mseokq23/mychip/(commit log)

2026-10-31 Add an end-to-end smoke test; make etri-lvs compare pins
    scripts/smoke-test.sh draws a 3/0.6 um NMOS in Magic and checks every
    step: tools, kit files, the ngspice and Xschem examples, Magic DRC, GDS
    layer numbers, KLayout DRC, LVS (devices, W/L, pins) and the noVNC port.
    etri-lvs now keeps the top cell as a subcircuit when it has ports, so
    Netgen compares pin names too; without ports it falls back to the bare
    top level and says so. It prints one verdict line and flags property
    (W/L) errors instead of reporting them as a plain match.
2026-10-31 Generate MOS test transistors from code; add etri-check
    designs/etri050/gen/etri050_mos.py computes single-finger NMOS/PMOS
    geometry on Magic's lambda grid and has Magic draw it in batch mode, so
    contacts, implants and wells come from the kit's ETRI GDS style. Each
    cell gets a schematic netlist for LVS; the v0 table
    (designs/etri050/teg/devices_v0.csv) also builds an unrouted array.
    etri-check runs Magic DRC, ETRI GDS export, KLayout DRC and LVS on a
    cell and prints one summary line. The KLayout deck lacks end-cap,
    contact-to-gate and implant-enclosure rules, so both DRCs are needed.
    The smoke test now also parses ngspice-47 output, which drops the
    spaces around "=" in echo.
2026-10-31 klayout-etri: show all hierarchy levels of opened layouts
    KLayout draws only the top cell by default, so the transistor array
    opened as empty cell frames. A small startup macro turns on
    full-hierarchy-new-cell before the layouts load.
2026-10-31 Add integrated TEG chip v0 in the 28-pin pad frame
    designs/etri050/gen/etri050_teg_chip.py builds three blocks with Magic
    (NMOS matrix of 8 with shared gate/source/substrate, PMOS matrix of 6
    with shared gate/source/N-well, 90 x 90 um MOS capacitor), routes them
    on metal3 to the kit's bare 28-pin frame without crossings, and merges
    the core GDS with the unchanged frame GDS into teg_chip_v0.gds.
    Checks: Magic DRC of the blocks and the core, KLayout DRC of the core
    and of the whole chip, LVS of the flattened core with the pad nets as
    ports, and a pad check. A pad map lists each route's length in squares
    for series-resistance de-embedding. 21 pads are used, 7 are left free.
    Device lists live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
2026-10-31 TEG chip: fix exit vias for the kit's KLayout rules
    Magic's ETRI style trims 0.05 um off via metal edges that touch no
    other metal, which left sub-minimum metal1/metal2 teeth where a bus or
    strip was taller than its via: bus vias now sit inside the bus metal,
    and the source via1, strip and via2 share one height.
    The kit deck checks VIA2 enclosure only against metal3 narrower than
    10 um, so wide routes laid over an exit via cut its enclosure. Routes
    now meet each exit via2 through a narrow neck and widen beyond it.
2026-11-01 Add control block teg_ctrl with self-checking testbench and qflow script
    RTL: 20-bit scan chain with shadow register, block decoders (array rows 12,
    columns 8, CBCM 10, RO 6), RO select and divide-by-256 reset by osel.
    The same testbench runs on the RTL and on the netlist synthesized with the
    kit liberty (157 checks). run_flow.sh follows the kit RTL_Project/ETRI050
    qflow steps and the kit DRC/LVS/stacked-via checks; not run yet.
2026-11-01 Add ngspice block checks for the on-chip characterization IC
    Array path with PANA diodes from the GPIO GDS, Kelvin sense position,
    switch TG on-resistance, CBCM (accuracy, frequency, pad resistor, C-V),
    31-stage RO bank, scan chain and divider, PNP thermometer through the pad
    resistor, and the W 9 um L-split (saturation current, Terada-Muta).
    run_all.py compares each result with the value used in the chip plan.
    PDK models are unpacked from the kit docs archive into build/ only.
2026-11-01 Fix the qrouter Tcl/Tk lookup and run graywolf's tests without rsync
    qrouter's configure picked /usr/lib/tk8.6/tkConfig.sh from the unpacked
    tk8.6-dev, which on Debian only sources /usr/lib/<arch>/tk8.6/tkConfig.sh
    by absolute path; that file exists only in the sysroot, so configure
    stopped. The multiarch tclConfig.sh and tkConfig.sh are now named directly.
    graywolf's test scripts copy each case with rsync, which the image lacks,
    so 5 of 6 cases failed within 0.2 s before running the placer. The tests
    now run as a separate step with a stand-in that makes the same copy
    (cp -RL), and the summary reads that log.
2026-11-01 Point qflow's generated exec script at the unpacked tcsh; keep $TOOLS intact
    qflow writes qflow_exec.sh starting with "#!/bin/tcsh -f" and then execs
    it, so the first flow run stopped with "qflow_exec.sh: Command not found".
    The installer now rewrites every "!/bin/tcsh" in the installed qflow
    scripts (shebangs and the echo lines that write generated shebangs) as a
    separate step that is safe to repeat.
    run_flow.sh assigned its tool prefix to TOOLS, which the image exports as
    /foss/tools and which /foss/tools/bin/yosys uses to find the real binary,
    so yosys failed inside the flow. The variable is renamed.
2026-11-01 Shape the control block for its floorplan slot and keep top pins on the side
    The first full run placed 52 pins on a ~423 x 396 um core's top side and
    pushed the last one (col_selb[7]) to x = 441 um, past the 432 um edge, so
    qrouter found no taps for it (1 failed net, 1 LVS pin error).
    run_flow.sh now sets the GrayWolf core aspect ratio (height / width) to
    0.37 instead of the kit template's 1.0: 7 rows, core 663 x 252 um, which
    matches the wide, low slot under the array and the RO bank. The top pin
    groups get sidespace hints (array selects 0.0-0.6, RO bank 0.62-0.98) so
    they spread from the left instead of piling up at the right end.
2026-11-01 Simulate the qflow netlist after dropping its repeated port wire declarations
    qflow's vlog2Verilog writes ANSI ports and then declares some of them again as wires; Icarus Verilog (12 and 14) rejects that. strip_port_wires.py removes only those lines before make qflowsim compiles the netlist.
2026-11-01 Use 8 rows for the control block and add flat and official-rule DRC checks
    Measured with the kit flow: aspect ratio 0.49 gives 8 rows (core 582 x 288
    um, block 604 x 301 um), which fits the floorplan slot between PNP2 and
    CBCM; 0.37 gave 685 x 265 um, too wide for it.
    run_flow.sh now also flattens the block with the kit's mag2gds.sh, runs
    Magic DRC on the flat cell, and runs the kit's KLayout conversion of the
    official rule deck on the ETRI GDS, summarized in flow_summary.txt.
2026-11-01 Record the control block place-and-route results and the metal spacing finding
    Kit flow checks are clean (no failed routes, LVS match, DRC 0 with only subcell-overlap tiles, no stacked vias, qflow netlist PASS 157). The official-rule KLayout deck flags 0.9 um metal2/metal3 spacing, which the kit LEF and 20 of 34 kit cells use and which also appears in the kit's FIR_PE Calibre results; to be confirmed with ETRI.
2026-11-01 Generate the pdkv pad ring from the kit's 28-pin GPIO template and check it against the template
2026-11-01 Generate the L-split NMOS pair and the N-well MOS capacitor as Magic cells with LVS netlists
2026-11-01 Record the direct device checks and the plan for the PNP and heater cells
2026-11-01 Add the PDK pnp10 copy and a poly2 heater built with the p2res layer set, with an official-deck check
2026-11-01 Record the PDK pnp10 and heater cells and their official-deck results
2026-11-01 Freeze the placed and routed control block as a GDS macro for chip assembly
2026-11-01 Record the control block pin locations next to its GDS macro
2026-11-01 Snap the control block macro to the 0.01 um design grid
    The kit qflow route is drawn in Magic quarter-lambda units (0.075 um), so the
    filled block had 3068 metal2 and 64 contact coordinates off the 0.01 um design
    grid of the rule document; ETRI's Calibre deck checks OFFGRID per layer.
    snap_grid.py moves every such coordinate (an odd multiple of 0.005 um) up by
    0.005 um, keeps polygon counts and via/contact coverage, and run_flow.sh now
    checks the snapped copy with the official-rule deck. freeze_macro.sh writes the
    macro and its pin list; gds_xor.py compares layouts by geometry.
2026-11-01 Assemble pdkv_Top from the pad ring, control block and direct devices
    assemble.py places the blocks in die coordinates and draws the routes to the
    rule document (0.8 um vias 0.8 um apart, 9 um power/force lines, 0.01 um grid).
    chip_check.py extracts the metal connectivity and checks every intended net,
    shorts between nets or inside a block, floating metal and the grid; run_chip.sh
    builds missing inputs, assembles, and runs the official-rule deck and the check.
2026-11-01 Add layout images of the assembled chip
2026-11-01 Place PNP1 beside the L-split with the heater under both
    The plan's thermal group puts PNP1 next to the reference device so it can see
    the L-split's own heating and the heater power alike. PNP1 now sits 37 um from
    the L-split channel, and the heater's long edge is 32 um from both; the heater
    return runs above the RO area into PVSS, and the PNP1/L-split ground comes on
    its own branch from PVSS.
2026-11-01 Document the chip assembly, its checks and results
    Chip README: floorplan, thermal group, routing rules, power and signal routes,
    the three checks and the Codespace results (official deck: the 14 pad ring
    5.NSD.S1 markers only; rule-document metal rules: nothing new; connectivity
    PASS; grid 0). Control block README: the 0.01 um grid snap and the frozen
    macro. Top README: the direct devices and chip folders.
2026-11-01 Add the chip boundary and the rule document seal ring to pdkv_Top
    CHIPBOUNDARY (layer 0) is the 1.9 x 1.9 mm MPW standard chip around the pad ring. The seal ring is a
    block of its own, drawn in the outer 30 um as the rule document 4.21 figure gives it, read with the
    digitized-area tone of each layer (table 2.1). metal_rules.py skips the ring zone for rules 7-12 as the
    kit deck does and checks the ring against the figure; chip_check sees the ring as one metal net.
    PDKV_SEAL=0 leaves both out.
2026-11-01 Add the Kelvin device array and route it into pdkv_Top
    etri050_array.py generates the 12 x 8 array (NMOS rows 0-7, PMOS rows 8-11, seven
    geometries and the open reference column) with per-cell drain sense TGs, row gate
    drivers and column force/sense/park switches; Magic DRC and Netgen LVS are clean.
    The row parking devices are W 6 um instead of the plan's 3 um for antenna margin.
    assemble.py places it above the control block: a constrained left-edge channel takes
    the 40 select lines to the column ports and to a metal2 bus for the row drivers, and the
    west pads ANW, ADF, ADS, ASF, ASS and AG are routed in.
    chip_check.py now holds every chip net to exactly the block nets under its probe
    poin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
2026-11-01 Extract the array's Kelvin path resistances and simulate them
    designs/etri050/array/kelvin_r.py extracts, from the drawn GDS with KLayout's R
    extractor, the resistance left inside each cell's Kelvin loop: the source vias, strip
    and plate up to the ASS sense point, and the drain strip between the force via and the
    sense tap (rule document 5.2/5.3 typ and max), with the contacts apart. It writes a
    per-cell table for correcting measurements.
    sim/blocks/array_post.py puts these into array_path.py's harness with the drawn switch
    sizes and per-cell drain sense, and run_all.py checks the result (step 'post').
2026-11-01 Document the Kelvin array, its routing, checks and post-layout results
    designs/etri050/array/README.md describes the circuit and where it departs from the
    plan (row parking W 6 um, column parking TG, force TG 100.8/252 um), the layout, the
    check results, the Kelvin path table and the post-layout simulation. The chip README
    gets the array placement, routing, the stricter short check, the antenna check and the
    Codespace results; render_gds.py can hide layers (the array close-up hides the plate).
2026-11-01 Note the current density in the array's drain contact strips
2026-11-01 Give the L-split's contact strip width in the array current note
2026-11-01 Add the CBCM capacitance table and the post-layout simulation
    cbcm_c.py extracts every cell's two nodes from cbcm_full.gds and sums their
    couplings with the rule document's capacitance table (5.4, 5.5); cbcm_post.py
    runs the block netlist with that wiring capacitance and the structures' drawn
    geometry. The table showed that the NG rail stopped at the east pairs' via, so
    cells 0 and 1 lacked the 0.18 fF that NG adds to every other ND; the rail now
    runs past their ND column and all pairs are alike again.
2026-11-01 Place the CBCM block in the chip
    The block sits east of the control block at die (1144.0, 456.0). Its clock and
    enables come straight from the control block's east-edge pins (en3 and en4
    cross the control block's own en2 route in metal2), VCD and VCR go to E1 and
    E2 PADR, VDD comes from S7, and its gnd rails join the south and east VSS
    lines. run_chip.sh builds the block when it is missing.
2026-11-01 Add the RO bank generator and its simulation
    etri050_ro.py draws the INV, NAND, NOR and wire ring oscillators (31 stages,
    NAND2X1 enable stage, tap INVX1 -> INVX4) from kit cells in six rows, with the
    wire RO's metal1 serpentines above them, and checks the block with a
    flattened Magic DRC and LVS. FO4 and the poly2-resistor RO do not fit in the
    place left for the bank; the README gives the reasons. ro_post.py runs the
    drawn ROs with the plan's loads and with the drawn wiring capacitance.
2026-11-01 Place the RO bank in the chip
    The bank sits over the control block, right of the array's row bus, at die
    (856.0, 826.0). Its enables and taps run on metal3 tracks in the corridor
    over the control block to the top-edge ro_en / ro_in pins; ro_in3 and ro_in5
    (ROs not built) stay tied to VSS. VDD comes from the control block's vdd bar
    on a metal1 line under the array channel, VSS from its gnd bar.
2026-11-01 Use each_circuit_top_down in the chip and antenna checks
    Netlist.top_circuit() is missing in KLayout 0.28 (the Ubuntu package);
    each_circuit_top_down() exists in 0.28 and 0.30 and gives the same circuit
    for the flat chip extraction. cbcm_c.py already uses it.
2026-11-01 Record the chip and simulation results with the RO bank
    Chip README: the RO bank in the block table, floorplan, power, signals,
    checks and results (local KLayout 0.28.16 run, checked against the
    Codespace record by re-running the merged state). The free areas left on
    the chip, measured from the chip GDS, include a strip above the heater's
    return line that takes the resistor RO, so that RO is planned as a block
    of its own instead of dropped; only FO4 stays out.
2026-11-01 Add the resistor RO block
    The plan's poly2-resistor RO (control-block index 5) did not fit the RO
    bank's place, but the chip has a free strip above the heater's return line
    (measured from the chip GDS), so it is a block of its own, rores: one
    flipped row in the interleaved order and, over every INVX1 stage, an upright
    poly2 resistor W 2 x L 80 um (40 squares) with the PDK p2res layer set;
    the stage output rises to its bottom head, a metal2 return line brings the
    top head down to the next stage's input.
    Magic draws each resistor's heads as a black-box cell p2r40 (LEFview), so
    Netgen compares the resistors as two-pin subcircuits and checks the ring
    order; KLayout inserts POLY2, CONT, LVSD, RE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
2026-11-01 Simulate the resistor RO before and after layout
    ro_post.py runs the resistor RO with the plan's loads plus the tap (68.6
    MHz, plan 69.1) and with the drawn wiring (rores_full.gds without POLY2)
    and the drawn resistor: p2res RSH x 40 squares with the PDK TC, a 50 ohm
    contact at each end and the body capacitance in ten segments (34.2 MHz).
    The rule document has no POLY2-to-field value, so POLY1's stands in as an
    upper bound; the run without body capacitance and RSH 110 / 140 ohm/sq
    bracket it. run_all.py checks both frequencies.
2026-11-01 Place the resistor RO in the chip
    The block sits at die (932.0, 1166.0) above the heater's return line.
    en5 / in5 cross the return line in metal3, run down the gap between the
    RO bank and MOS-C and join the corridor over the control block on two more
    tracks to ro_en[5] / ro_in[5]; ro_in5 is no longer tied to VSS. VDD and
    VSS come from the RO bank's west straps, apart from the heater's own
    return. run_chip.sh: 12 blocks, official deck 46 (unchanged), rules 7-12
    16 (all in the pad-ring baseline), 85 nets / 237 points PASS, no antenna
    violation without diffusion; a fresh checkout reproduces the same GDS.
2026-11-01 Check the resistor RO at device level
    Netgen compares each poly2 resistor as the black box p2r40 and never sees
    the POLY2, CONT, LVSD and RES shapes added after Magic. rores_lvs.py
    extracts rores_full.gds with KLayout (MOS4 transistors, resistor body =
    POLY2 & LVSD & RES at 125 ohm/sq, heads through CONT to MET1) and compares
    it with the generator's circuit at transistor level with 5000 ohm
    resistors: 35 NFET, 35 PFET, 30 RES match. Seven injected errors in the
    reference or the layout all give a mismatch. etri050_ro.py --check runs it.
    Docs: the stage load after the resistor is the plan's in shape but
    heavier (19.6-22.4 fF against 5 fF), so the chip is compared with the
    drawn-wiring value;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
2026-11-01 Check that the VSS branches meet only in the PVSS pad
    All VSS probe points share one net name, so the short check cannot see the
    heater return or the PNP1 / L-split branch touching the core ground.
    assemble.py tags each VSS point with its branch (core, PNP1 and L-split,
    heater return) and chip_check.py extracts the chip again without the pad
    ring: each branch must be one net and no two branches one net. A via2
    between the resistor RO's VSS metal3 and the heater return line, or a
    metal1 bridge from the east VSS line to the PNP1 branch, passes the other
    checks and is caught here. The chip geometry is unchanged (XOR 0).
    Also correct the comment on ro_in[5] (it crosses the y 765-767 tie line)
    a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
2026-11-01 Use ETRI's own GPIO cells in the pad ring
    The kit draws the pad ring with Magic copies of ETRI's GPIO cells
    (pads_ETRI/GDS_Magic) and writes them with the ETRI-G style. Those copies
    are not ETRI's layout: PANA's P+/N-well ESD diodes (pdiode10, 12 per cell)
    have no N-well paint, so the written GDS has no N-well there and each
    diode's p+ anode on the pad becomes a substrate contact, tying all 20
    PANA pads to the substrate. The implants are also redrawn (the 14
    5.NSD.S1 markers of the ring came from them) and RES, LVSD, DIODE and
    ESDD are missing.
    pad_gds.py keeps Magic's ring (64 instances and their transforms) and
    copies every cell that ETRI's library has unchanged from
    ETRI_NSPL_GPIO_250610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
2026-11-01 Check wells and substrate ties on the chip GDS
    Block LVS compares Magic's own database, so a layer lost when Magic
    writes GDS (as the N-well of the kit's PANA diodes was) is not seen
    there. chip_check.py now checks the GDS itself: every gate carries one
    implant, PSD inside an N-well or NSD outside one, and no net that reaches
    p+ in the substrate also reaches a bond pad other than PVSS.
    On the chip: 3420 gates all in place, 3 nets on substrate p+ (VSS, the
    seal ring, a guard ring inside POB4), only PVSS among the bond pads. On
    the previous chip with the Magic pad cells it flags all 20 PANA bond pads.
2026-11-01 Write ETRI's one-by-one arrays as single placements
    ETRI's GPIO GDS places 18 subcells in PANA, PIC and POB4 as 1 x 1 arrays
    with real pitch vectors; KLayout writes them back with zero vectors,
    which some stream readers refuse. pad_gds.py now writes each 1 x 1 array
    as a single placement and names the pad ring library pdkv_Pad instead of
    ETRI's library name. Geometry and labels are unchanged (XOR 0 on every
    layer, same texts) and the chip checks give the same results.
    Also count the pads tied to the substrate by bond pad (all 20; the 14
    PADR ports reach it through the series resistor) and redraw the chip and
    pad ring pictures from the new GDS.
2026-11-01 Freeze the control macro's gate netlist with its GDS
    macro/teg_ctrl.v is build/qflow/synthesis/teg_ctrl.rtlnopwr.v of the qflow run that produced macro/teg_ctrl.gds.gz: that run's teg_ctrl_F_grid.gds and the macro have identical geometry (scripts/gds_xor.py) and its LVS matched uniquely. 255 cells including 15 FILL, as the README records. The chip's device-level LVS reads this netlist.
2026-11-01 Freeze the control macro's SPICE netlist too
    macro/teg_ctrl.spc is the teg_ctrl subcircuit of build/qflow/synthesis/teg_ctrl.spc from the same run, the netlist qflow's LVS compared the layout with (vlog2Spice of teg_ctrl.rtl.v; the kit cell library it includes is left out). macro/teg_ctrl.v has no power pins, so qflow's vlog2Spice cannot rebuild this file from it.
2026-11-02 Keep the macro's netlists in freeze_macro.sh
    freeze_macro.sh now also copies build/qflow/synthesis/teg_ctrl.rtlnopwr.v to macro/teg_ctrl.v and
    the teg_ctrl subcircuit of synthesis/teg_ctrl.spc to macro/teg_ctrl.spc, so a later freeze keeps
    the GDS and the netlists that made it together. The README notes why the netlist has to be frozen
    (qflow re-buffers after placement, and a placement on another machine differs) and that the macro
    GDS alone matches teg_ctrl.spc at device level (978 NMOS, 1029 PMOS, 1015 nets, 70 pins).
2026-11-02 Check the chip core at device level and the Kelvin pairs on the metal
    chip_lvs.py compares everything inside the pad ring with the circuit at device level (KLayout):
    devices recognized as ETRI's Calibre LVS deck V1.1 does (MOS, P2RES W/L, PIPCAP W/L from its LVSD
    strip, PNP with the 4/25/100 um2 emitter and a closed collector ring), taps soft-connected with the
    soft-connection log as a failure, pins at the pad cells' metal2 core ports (ports the ring's own metal
    joins are joined: the two PVDD pads), the 9 um line required at force ports, and anchors at the array
    select pins, the CBCM enables and the CBCM structure nodes so that cells of identical devices cannot
    swap unseen. The reference com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
2026-11-02 Simulate the whole chip core at transistor level from the LVS netlist
    chip_post.py runs the netlist chip_lvs.py extracts and matches (devices only, pads as sources at the
    pad cells' core ports):
    - scan: five frames (modes 01, 01, 00, 10, 11) at TT 27 C, SS 125 C 4.5 V and FF 27 C 5.5 V; every
    select and enable line after each SLE and halfway through the next shift, 80 read-back bits on OUT
    - array: I(ADF) against the device a measurement assumes (gate on AG, drain at the ADS voltage,
    source on SRC), the selected row's gate at AG, nothing drawn from AG, mode 00
    - CBCM: cell 1 against the block netlist reading the same plate (reltol 1e-5 as cbcm_block.py),
    cell 0, CBCM_CLK running in mod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
2026-11-02 Check the control block timing with the drawn wiring; add ERC, GDS, current density and Calibre-only checks
    chip_rc.py counts every core net's wiring capacitance from the GDS (rule document table 5.5, the
    method of cbcm_c.py and ro_post.py, whose block nodes it reproduces to 0.01 fF; 1372 nets, 34.3 pF),
    a same-layer coupling estimate and a resistance bound for the clock nets, and the POB4 input stage.
    chip_timing.py runs the chip netlist with that wiring and the drawn POB4 load:
    - scan at TT 27 C, SS 125 C 4.5 V, FF 27 C 5.5 V and, for hold, FF 0 C 5.5 V, FS and SF 27 C:
    shift pattern, 19 shift races, clk->Q, clock insertion and skew, SCK -> OUT, SDI
    - the drawn DFFPOSX1 alone: hold (fas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
2026-11-02 Keep the scribe lane free: no seal ring by default, check the frame, zip the GDS
    The 2026-4 MyChip announcement gives the chip as 1.9 x 1.9 mm including a
    120 um scribe lane, and the PDK's MPW_PAD_28pin.gds marks 0-1900 and
    60-1840 um on TEXT 48: the outer 60 um of each side is scribe lane. The
    rule document 4.21 seal ring drawn in the outer 30 um lies in it, and
    inside it (60-90 um) it would leave 7.5 um to the pad ring, not the 30 um
    the figure asks. ETRI's GDS template and the fabricated precedents
    (FIR_PE, pong_pt1) have no seal ring and no layer 0, so the chip now goes
    in the same way: assemble.py and run_chip.sh leave both out unless
    PDKV_SEAL=1 (-rd seal=1). Every other layer is uncha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
2026-11-02 Keep the layouts alive in gds_xor.py
    regions() returned regions read from a layout that was freed when the
    function returned. KLayout 0.28.16 then crashed (signal 11) part way
    through the layers, after printing the first ones: comparing the
    submitted pdkv_Top.gds with a fresh assembly stopped at the CAP layer.
    The layouts now stay referenced for the whole run, and only boxes,
    polygons and paths are read (texts are no geometry). The submitted GDS
    against a fresh assembly of main: identical geometry on all 21 layers;
    against the earlier chip with seal ring: the 9 layers of the ring and
    the chip boundary differ, as they should.
2026-11-02 Add a device map of the chip core for KLayout's marker browser
    device_map.py takes the devices chip_lvs.py extracts inside the pad ring,
    as drawn, and writes build/pdkv_devices.lyrdb: block > device type and
    size > device, each a marker on the device's box with its parameters
    and the nets on its terminals (named after the reference netlist on a
    match). Blocks: L-split 2, MOS-C 4, PNP1 1, PNP2 1, heater 1, Kelvin
    array 456, CBCM 133, RO bank 400, resistor RO 100, control block 2007;
    NFET 1504, PFET 1567, P2RES 31, PIP 1, PNP 2 as chip_lvs.py counts them.
    The chip README shows how to open it in KLayout together with the LVS
    database (klayout-etri pdkv_Top.gds -m pdkv_devices.lyrdb -mn
    pdkv_co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
2026-11-08 Reflect ETRI's answers: conservative heater path, force landings, PCM comparison
    ETRI answered the MyChip QnA on 2026-11-06: no verified current limits for metal,
    poly2, contacts or vias; draw structures with a continuous current such as heaters
    conservatively; open-source DRC/LVS results are accepted but the outcome is the
    designer's (no DRC review by ETRI); the PAD port is the designer's call; TEG results
    of the 2026-1 MPW.
    - Heater path: the head metal1 covers the whole 20 um head; HT runs as two 9 um
    metal2 lines (40 VIA1); the return as three risers, a metal1 strap under the
    metal2 line past the RO bank, and three lines into PVSS with the strap tied to
    the line over each. At 8.3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
2026-11-09 Final pre-submission checks: self-test, pin table, notes
    - checks_selftest.py: the ROW_SEL3 case looks for the floating net's 9 gates
    instead of its name. Magic 8.3.685 writes no port labels into the array
    GDS, so in a Codespace build the net is named $<n>, not row_sel3, and the
    case was reported as missed although the ERC caught the fault.
    - pins.csv: package lead numbers (notice #768), the heater driven by a
    current source of at most 5 mA, ANW kept at or above every array pin.
    - Notes: the final verification in the chip README, the CBCM 1.PWL.bad2
    decision, the v0 transistor table header, and a link to the final
    repository (etri050-pdkv) in the top README.
